mbmorrissey/minimalweatherstation/schematic/Schematic_Minimal Weather Station_2023-12-16.pdf

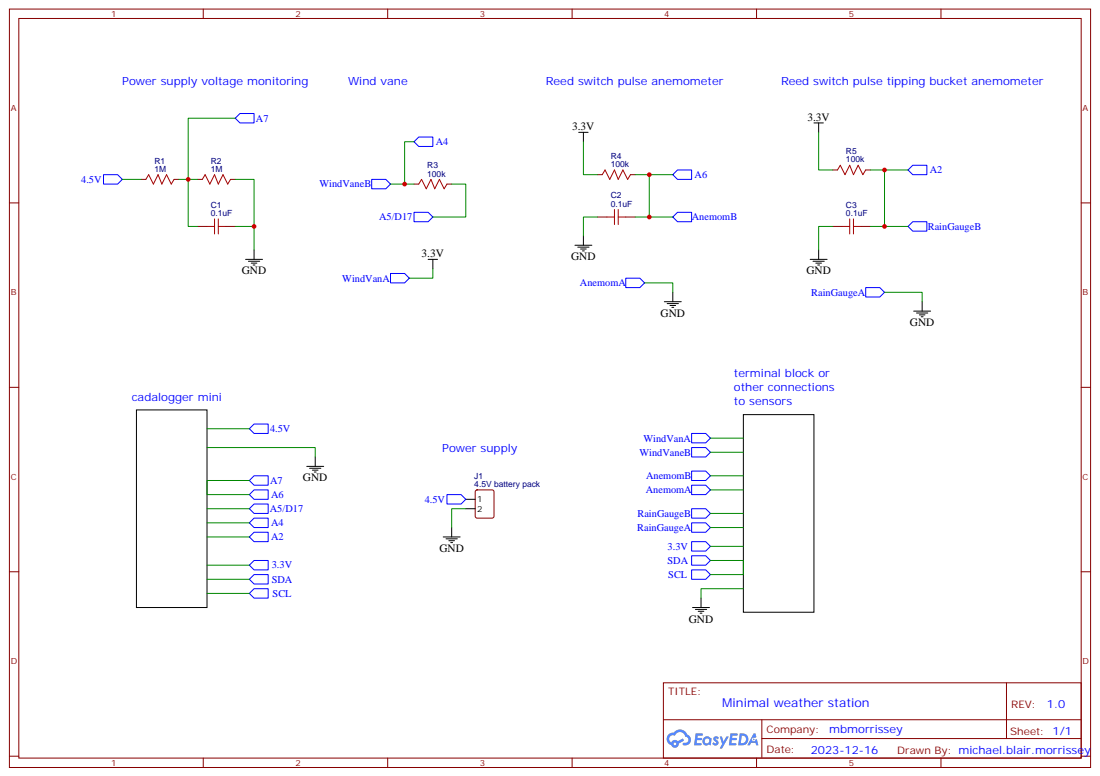
[picture p5: page 1]

Drawn By: michael.blair.morrissey
