mbmorrissey/minimalweatherstation/testing_data/power_profile_raw.csv

Timestamp(ms) | Current(uA)
17905 | 57.627
17906 | 55.871
17907 | 54.302
17908 | 55.477
17909 | 61.899
17910 | 74.320
17911 | 90.171
17912 | 107.297
17913 | 123.511
17914 | 106.726
17915 | 80.043
17916 | 64.204
17917 | 42.674
17918 | 34.870
17919 | 36.934
17920 | 36.999
17921 | 36.085
17922 | 34.908
17923 | 33.079
17924 | 32.330
17925 | 31.763
17926 | 31.556
17927 | 31.805
17928 | 31.413
17929 | 31.805
17930 | 31.327
17931 | 31.316
17932 | 31.319
17933 | 31.552
17934 | 31.729
17935 | 31.209
17936 | 30.731
17937 | 30.302
17938 | 29.659
17939 | 29.648
17940 | 29.187
17941 | 29.084
17942 | 28.747
17943 | 27.748
17944 | 27.254
17945 | 27.962
17946 | 27.792
17947 | 28.274
17948 | 28.543
17949 | 28.795
17950 | 28.764
17951 | 28.855
17952 | 29.011
17953 | 29.798
17954 | 30.119
17955 | 29.876
17956 | 29.398
17957 | 28.918
17958 | 28.808
17959 | 28.432
17960 | 28.336
17961 | 28.392
17962 | 27.920
17963 | 103.863
17964 | 91.245
17965 | 70.834
17966 | 63.969
17967 | 61.904
17968 | 61.073
17969 | 60.486
17970 | 60.312
17971 | 60.858
17972 | 61.359
17973 | 61.957
17974 | 61.399
17975 | 60.924
17976 | 60.551
17977 | 60.303
17978 | 59.509
17979 | 60.105
17980 | 59.737
17981 | 59.664
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
