mbmorrissey/minimalweatherstation/(commit log)

2023-12-16 add source code and schematic
2023-12-21 work on power profile
    [power_profile_raw.csv]
2023-12-21 working on power profile
